Nilcreator/NinjaRobotV5/Wiki/NinjaRobotPi0_Wiki/raw/articles/pi0vl53l0x/README.md

# pi0vl53l0x

A robust Python driver for the VL53L0X Time-of-Flight distance sensor using pigpio.

## Features

- **Hardened initialization** — firmware boot polling (up to 1.0s) prevents "returns 0 after reboot" issue
- **Thread-safe ranging** — individual I2C operations and whole single-shot ranging transactions are serialized for background monitor + Blockly use
- **Automatic retry** — exponential backoff (10→20→50ms) with bus recovery on persistent failure
- **Defined exception contract** — `I2CError`, `TimeoutError`, `RuntimeError` for clear error handling
- **Async ready** — `get_range_async()` for asyncio integration
- **Config management** — JSON-based offset storage with export/import
- **Interactive CLI** — `sensor-tool` TUI with 8 menu options for guided sensor operations
- **Individual commands** — `get`, `test`, `status`, `calibrate`, `performance`, `config` for scripting
- **100% backward compatible** — drop-in replacement for ninja_core integration

## Directory Structure

```
pi0vl53l0x/
├── pyproject.toml              # Package metadata, dependencies, CLI entry point
├── README.md                   # This document
├── LICENSE
├── tests/                      # Unit tests (61 tests total)
│   ├── test_i2c.py             # I2C bus wrapper tests (22 tests)
│   ├── test_sensor.py          # VL53L0X driver tests (23 tests)
│   └── test_config.py          # Config manager tests (16 tests)
└── src/pi0vl53l0x/
    ├── __init__.py              # Package exports (VL53L0X, ConfigManager, I2CError)
    ├── __main__.py              # Entry point for `python -m pi0vl53l0x`
    ├── registers.py             # ~60 semantic register constants
    ├── driver.py                # Backward-compat shim (re-exports VL53L0X from core)
    ├── core/                    # Core sensor modules
    │   ├── __init__.py
    │   ├── i2c.py               # Thread-safe I2C bus wrapper with retry + recovery
    │   └── sensor.py            # VL53L0X driver (~1000 lines, implements Sensor ABC)
    ├── config/                  # Configuration management
    │   ├── __init__.py
    │   └── config_manager.py    # JSON load/save/export/import
    └── cli/                     # CLI commands
        ├── __init__.py
        └── sensor_tool.py       # Individual commands + interactive sensor-tool TUI
```

## Requirements

- Python ≥ 3.9
- `click` — CLI framework
- `blessed` — Terminal UI for interactive tool
- `ninja_utils` — logging and Sensor ABC
- `pigpio` — Raspberry Pi I2C (required on RPi)

## Installation (Standalone on Raspberry Pi)

### Step 1: Install `uv` (Python package manager)

```bash
curl -LsSf https://astral.sh/uv/install.sh | sh
source ~/.bashrc    # or restart your terminal
```

> **Note:** `uv` is a fast Python package manager that replaces `pip` and `venv`. It automatically creates a `.venv` and manages all dependencies.

### Step 2: Clone and install pi0vl53l0x

```bash
# Clone the repository (or copy the pi0vl53l0x folder to your Pi)
cd pi0vl53l0x

# Install all dependencies including pigpio for Raspberry Pi
uv sync --extra pi
```

### Step 3: Start pigpiod

```bash
sudo pigpiod
```

> **Tip:** To start pigpiod automatically on boot:
> ```bash
> sudo systemctl enable pigpiod
> ```

### Step 4: Verify installation

```bash
uv run pi0vl53l0x --help
uv run pi0vl53l0x test
```

## CLI — Interactive Sensor Tool

Launch the interactive TUI with 8 menu options for guided sensor operations:

```bash
# Launch the interactive TUI
uv run pi0vl53l0x sensor-tool

# With custom config file
uv run pi0vl53l0x sensor-tool --config my_sensor.json
```

The `sensor-tool` provides a menu-driven interface:

| # | Function | Description |
|---|---|---|
| 1 | Single Read | Take one distance measurement (repeat with Enter) |
| 2 | Continuous Read | Stream readings at configurable interval |
| 3 | Performance | Measure readings/second with statistics |
| 4 | Calibrate | Guided offset calibration at known distance |
| 5 | Health Check | Verify sensor connection and test reading |
| 6 | Status | Full diagnostics (health, offset, config, reading) |
| 7 | Config | Show/export/import sensor settings |
| 8 | Reinitialize | Reset sensor for recovery from stuck state |

## CLI — Individual Commands

Individual commands are ideal for scripting, automation, and quick one-off operations.

### Read Distance

```bash
# Single reading
uv run pi0vl53l0x get

# 10 readings at 0.5s intervals
uv run pi0vl53l0x get --count 10 --interval 0.5
```

### Quick Test

```bash
# Initialize sensor and take 5 test readings
uv run pi0vl53l0x test
```

### Health Status

```bash
# Full sensor health report (connection, offset, reading, config)
uv run pi0vl53l0x status
```

### Performance Benchmark

```bash
# Measure readings per second (100 samples)
uv run pi0vl53l0x performance --count 100
```

### Calibration

```bash
# Place a target at exactly 100mm from sensor, then run:
uv run pi0vl53l0x calibrate --distance 100 --count 10
```

### Configuration Management

```bash
# View current settings
uv run pi0vl53l0x config show

# Backup configuration
uv run pi0vl53l0x config export backup.json

# Restore configuration
uv run pi0vl53l0x config import backup.json
```

### Global Options

```bash
# Enable debug logging
uv run pi0vl53l0x --debug get --count 5

# Use custom config file
uv run pi0vl53l0x --config-file custom.json get
```

## Quick Start

### Python API

```python
import pigpio
from pi0vl53l0x import VL53L0X

pi = pigpio.pi()
sensor = VL53L0X(pi)  # Auto-initializes with firmware boot polling

# Single measurement
distance = sensor.get_range()
print(f"Distance: {distance} mm")

# Structured data with validity check
data = sensor.get_data()
if data["is_valid"]:
    print(f"Distance: {data['distance_mm']} mm (raw: {data['raw_value']} mm)")

# Calibration at known distance
offset = sensor.calibrate(target_distance_mm=100, num_samples=10)
sensor.set_offset(offset)

# Health check and recovery
if not sensor.health_check():
    sensor.reinitialize()

sensor.close()
pi.stop()
```

### Context Manager

```python
with VL53L0X(pi) as sensor:
    distance = sensor.get_range()
```

### Async Support

```python
distance = await sensor.get_range_async()
```

### Using with ninja_core (HAL Integration)

The library is loaded automatically by `ninja_core/hal.py` via the driver registry:

```python
# ninja_core imports it as:
from pi0vl53l0x.driver import VL53L0X
sensor = VL53L0X(pi)  # driver.py is a shim that re-exports from core.sensor
```

No changes to `ninja_core` are needed — both import paths work identically.

## API Reference

### VL53L0X (Constructor)

```python
VL53L0X(
    pi: pigpio.pi,
    i2c_bus: int = 1,
    i2c_address: int = 0x29,
    debug: bool = False,
    config_file_path: str | None = None,
    firmware_boot_timeout: float = 1.0,
)
```

| Parameter | Default | Description |
|---|---|---|
| `pi` | (required) | Shared pigpio connection |
| `i2c_bus` | `1` | I2C bus number |
| `i2c_address` | `0x29` | 7-bit I2C address |
| `debug` | `False` | Enable debug logging |
| `config_file_path` | `None` | Path to JSON config with `offset_mm` |
| `firmware_boot_timeout` | `1.0` | Firmware boot timeout in seconds |

> **Note:** The constructor auto-calls `initialize()`. If init fails, the I2C handle is cleaned up automatically.

### Measurement Methods

| Method | Returns | Description |
|---|---|---|
| `get_range()` | `int` | Single-shot distance in mm (with offset applied) |
| `get_data()` | `dict` | `{"distance_mm", "is_valid", "raw_value", "timestamp"}` |
| `get_ranges(num_samples)` | `list[int]` | Multiple consecutive measurements |
| `get_range_async()` | `int` | Async version (runs in thread pool executor) |

### Thread Safety

`I2CBus` serializes individual register reads and writes. `VL53L0X` also serializes the complete single-shot ranging transaction with an internal re-entrant measurement lock, so a background `DistanceMonitor` read and Blockly user code calling `robot.distance.read()` cannot interleave the register writes that start, poll, and clear a measurement.

`get_range()`, `get_data()`, `get_ranges()`, `get_range_async()`, `reinitialize()`, and `close()` all use this transaction-level protection where needed. This is important inside NinjaRobotV5 because the web IDE can execute Blockly loops while the server is also polling the same physical VL53L0X sensor.

### Calibration & Configuration

| Method | Returns | Description |
|---|---|---|
| `set_offset(offset_mm)` | `None` | Set distance offset in mm |
| `calibrate(target_distance_mm, num_samples)` | `int` | Measure and return calculated offset |

### Health & Recovery

| Method | Returns | Description |
|---|---|---|
| `health_check()` | `bool` | Verify sensor responds (reads Model ID) |
| `reinitialize()` | `None` | Full re-init for recovery; serialized with active ranging transactions |
| `close()` | `None` | Release I2C handle |

### I2CBus

Thread-safe I2C wrapper used internally by VL53L0X. It protects individual bus operations; the VL53L0X driver layers a measurement transaction lock above it for multi-register ranging flows.

```python
from pi0vl53l0x.core.i2c import I2CBus

bus = I2CBus(pi, bus=1, address=0x29, max_retries=3)
value = bus.read_byte(0xC0)  # Read Model ID register
bus.close()
```

| Method | Returns | Description |
|---|---|---|
| `read_byte(register)` | `int` | Read single byte |
| `write_byte(register, value)` | `None` | Write single byte |
| `read_word_big_endian(register)` | `int` | Read 16-bit word (byte-swap) |
| `write_word_big_endian(register, value)` | `None` | Write 16-bit word (byte-swap) |
| `read_block(register, count)` | `list[int]` | Read block of bytes |
| `write_block(register, data)` | `None` | Write block of bytes |
| `close()` | `None` | Close I2C handle |

### ConfigManager

```python
from pi0vl53l0x.config import ConfigManager

manager = ConfigManager()         # Uses default vl53l0x.json path
manager.load()                    # Load config from file
manager.set("offset_mm", 10)      # Set a value
manager.save()                    # Save to file
manager.export_config("backup.json")
manager.import_config("backup.json")
```

### Exception Contract

| Exception | When |
|---|---|
| `I2CError` | I2C bus failure after all retries exhausted |
| `TimeoutError` | Measurement/firmware boot did not complete within timeout |
| `RuntimeError` | Sensor not initialized |
| `ConnectionError` | Invalid Model ID (expected 0xEE) or connection failure |

## Testing

```bash
# Run all unit tests (61 tests)
uv run --extra dev pytest tests/ -v

# Lint check
uv run --extra dev ruff check src/ tests/
```

### Test Coverage

| Test File | Tests | Coverage |
|---|---|---|
| `test_i2c.py` | 22 | I2C ops, retry, recovery, thread safety |
| `test_sensor.py` | 23 | Init, ranging, offset, health, async, transaction lock, compat |
| `test_config.py` | 16 | Load/save, export/import, corrupt JSON |

### Manual Testing on Raspberry Pi

1. Start pigpiod: `sudo pigpiod`
2. Quick test: `uv run pi0vl53l0x test`
3. Health check: `uv run pi0vl53l0x status`
4. Read distances: `uv run pi0vl53l0x get --count 5`
5. Calibrate: `uv run pi0vl53l0x calibrate --distance 100 --count 10`
6. Interactive tool: `uv run pi0vl53l0x sensor-tool`

## Architecture

```
┌──────────────────────────────────────────────┐
│                  ninja_core                   │
│     hal.py → from pi0vl53l0x.driver import   │
│              VL53L0X (backward-compat shim)   │
└─────────────────────┬────────────────────────┘
                      │
┌─────────────────────▼────────────────────────┐
│              pi0vl53l0x package                │
│                                               │
│  ┌──────────┐  ┌──────────┐  ┌────────────┐  │
│  │ core/    │  │ config/  │  │ cli/       │  │
│  │  i2c.py  │  │ config_  │  │ sensor_    │  │
│  │  sensor  │  │ manager  │  │ tool.py    │  │
│  │  .py     │  │ .py      │  │            │  │
│  └────┬─────┘  └────┬─────┘  └────┬───────┘  │
│       │              │              │          │
│  registers.py   vl53l0x.json    click CLI     │
└──────────────────────────────────────────────┘
                      │
              pigpio I2C (bus 1)
                      │
              VL53L0X sensor (0x29)
```

## License

MIT License — © 2026 Chihkuang Chang
