Nilcreator/NinjaRobotV5/Wiki/NinjaRobotPi0_Wiki/wiki/concepts/perception-and-expression.md

---
type: Concept
title: Perception and Expression Systems
description: Time-of-Flight distance sensing, thread-safe measurement locks, animated
  LCD expressions, and emotion audio synthesis.
status: stable
generated:
  by: antigravity-agent/1
  at: '2026-08-22T14:22:00Z'
sources:
- id: src-20260822-readme-5
  resource: urn:llmwiki:source:src-20260822-readme-5
  title: pi0buzzer Readme
  content_hash: sha256:5b4e579a60463a96e8f0bec64a502a6bf78e068b0190f65e7793fa52666d0d45
- id: src-20260822-readme-6
  resource: urn:llmwiki:source:src-20260822-readme-6
  title: pi0disp Readme
  content_hash: sha256:2fe0452ebd0ffac5fad08cfc6c0452dd65acdc62f318b71d7050e123bb347682
- id: src-20260822-readme-8
  resource: urn:llmwiki:source:src-20260822-readme-8
  title: pi0vl53l0x Readme
  content_hash: sha256:6d02713847e83b720c6093afade910a3989dc1e8d8b48d889d61c1e381b7b680
- id: src-20260822-developmentguide
  resource: urn:llmwiki:source:src-20260822-developmentguide
  title: NinjaRobot V5 Development Guide
  content_hash: sha256:26272dce2ec7dcab9f3181e1ce0621448ef12547ff26f3b7a0ac4fc50cef9b4d
semantic_review:
  version: 1
  performed_by: agent:codex
  performed_at: '2026-09-01T07:28:37Z'
  target_hash: sha256:be0b0a4fec178421bbf8bbdeb4dfc8640ff7f33cb64d2e0ed8308e78c1492be7
  result: passed
  checks:
    source_support: passed
    contradictions: passed
    limitations: passed
    claim_strength: passed
    visual_evidence: not_applicable
  notes:
  - Driver concurrency and expression behavior are supported; bandwidth and responsiveness claims remain
    attributed to documentation rather than physical benchmarks.
---

# Perception and Expression Systems

NinjaRobot V5 combines environmental perception with multi-modal expressions (visual and acoustic) to deliver an engaging, interactive personality.[^src-20260822-developmentguide]

## Distance Perception (`pi0vl53l0x` & `DistanceMonitor`)

Distance sensing uses the VL53L0X Time-of-Flight sensor over I2C:[^src-20260822-readme-8]

* **Transaction-Level Locking**: Ranging requires multi-register read/write sequences. `pi0vl53l0x` wraps transactions in a `threading.RLock` so background polling in `DistanceMonitor` and user code in Blockly (`robot.distance.read()`) do not corrupt I2C bus state.[^src-20260822-readme-8] [^src-20260822-developmentguide]
* **Automatic Bus Recovery**: Transient I2C communication failures trigger exponential backoff (10→20→50ms) and automatic bus reset.[^src-20260822-readme-8]
* **Obstacle Safety**: In autonomous mode, proximity < 50mm immediately halts movements, displays a `scary` face, and triggers a warning sound.[^src-20260822-developmentguide]

## Visual Expressions (`pi0disp` & `AnimatedFaces`)

The visual expression engine renders expressive eyes and faces onto the 240×320 IPS display:[^src-20260822-readme-6] [^src-20260822-developmentguide]

* **Smart Delta Rendering**: `pi0disp` calculates bounding boxes of modified pixels via `PIL.ImageChops.difference()`, transmitting only changed areas over SPI; the source documentation reports approximately 90% bandwidth reduction for animations.[^src-20260822-readme-6]
* **Thread-Safe SPI Lock**: Protects display transfers against concurrent access by web server status threads and facial animation loops.[^src-20260822-readme-6]
* **Expression Library**: Pre-rendered and dynamic animations including `happy`, `sad`, `angry`, `confusing`, `cry`, `embarrassing`, `idle`, `laughing`, `scary`, `shy`, `sleepy`, `speaking`, and `surprising`.[^src-20260822-readme-6] [^src-20260822-developmentguide]

## Acoustic Emotion Synthesis (`pi0buzzer`)

Audio is generated using a passive buzzer driven by hardware PWM on GPIO 17:[^src-20260822-readme-5]

* **Non-Blocking Queue Worker**: Sound sequences are processed in a dedicated background worker thread, keeping queued playback work off the calling thread.[^src-20260822-readme-5]
* **Musical Notes**: 35 standard note frequencies across 5 octaves (C3–B7).[^src-20260822-readme-5]
* **14 Emotion Sound Effects**: Acoustic signatures mapped to matching facial expressions.[^src-20260822-readme-5]
* **Built-in Song Catalog**: Melodies including `happy_birthday`, `jingle_bells`, `twinkle_twinkle_little_star`, and `head_shoulders_knees_and_toes`.[^src-20260822-developmentguide]

[^src-20260822-readme-5]: pi0buzzer Readme.
[^src-20260822-readme-6]: pi0disp Readme.
[^src-20260822-readme-8]: pi0vl53l0x Readme.
[^src-20260822-developmentguide]: NinjaRobot V5 Development Guide.
