Nilcreator/NinjaRobotV5/Wiki/NinjaRobotPi0_Wiki/wiki/concepts/index.md

# Concepts

* [Action Library and AI Agent](action-library-and-ai-agent.md) - Google Gemini-powered agentic AI, saved Blockly action library, action chaining, and cooperative interruption.
* [Architecture and Hardware Abstraction Layer](architecture-and-hal.md) - Monorepo structure, dynamic driver loading, interface ABCs, and centralized configuration in NinjaRobot V5.
* [Dual Connectivity and Communication Protocols](dual-connectivity-and-protocols.md) - Dual Wi-Fi and Bluetooth Low Energy connectivity, GATT service specifications, and chunked transfer protocols.
* [Motion System and Easing Curves](motion-system-and-easing.md) - Velocity-based physics motion calculations, position-aware easing curves, and the movement command syntax.
* [Perception and Expression Systems](perception-and-expression.md) - Time-of-Flight distance sensing, thread-safe measurement locks, animated LCD expressions, and emotion audio synthesis.
* [Safe Code Execution and Blockly Runtime](safe-execution-and-blockly-runtime.md) - Sandboxed Python execution, AST compilation preflight, runtime ownership switching, and GPIO-first wrapper contracts.
