Nilcreator/NinjaRobotV5/Wiki/NinjaRobotPi0_Wiki/wiki/analyses/index.md

# Analyses

* [Development History and Evolution](development-history-and-evolution.md) - Chronological development history of NinjaRobot V5 across major phases, version milestones, and reliability audits.
* [Hardware Driver Rebuild and Vulnerability Analysis](driver-rebuild-and-vulnerability-analysis.md) - In-depth analysis of legacy driver limitations, blocking delays, concurrency race conditions, and V5 architectural solutions.
