Nilcreator/NinjaRobotV5/Wiki/NinjaRobotPi0_Wiki/wiki/references/index.md

# References

* [API and CLI Reference](api-and-cli-reference.md) - Unified reference of all Python driver classes, wrapper APIs, REST/WebSocket endpoints, and CLI tools.
* [Hardware Calibration and Testing Tools Reference](hardware-calibration-and-tools.md) - Comprehensive guide to interactive calibration TUIs, setup wizards, and diagnostic tools.
* [Installation and Hardware Wiring Reference](installation-and-wiring.md) - Step-by-step assembly, complete GPIO wiring tables, Raspberry Pi OS Bookworm setup, and pigpio compilation.
