Nilcreator/NinjaRobotV5/Wiki/NinjaRobotPi0_Wiki/wiki/log.md

# Wiki Update Log

## 2026-09-01

* **Update**: Applied plan `plan-20260901-review-safe-execution-and-blockly-runtime` — Record a source-backed semantic review for wiki/concepts/safe-execution-and-blockly-runtime.md; page content is unchanged.. Sources: `src-20260822-developmentguide`, `src-20260822-readme-3`, `src-20260822-developmentlog`.

* **Update**: Applied plan `plan-20260901-review-pi0vl53l0x` — Record a source-backed semantic review for wiki/entities/pi0vl53l0x.md; page content is unchanged.. Sources: `src-20260822-readme-8`, `src-20260822-developmentguide`, `src-20260822-developmentlog`.

* **Update**: Applied plan `plan-20260901-review-pi0servo` — Record a source-backed semantic review for wiki/entities/pi0servo.md; page content is unchanged.. Sources: `src-20260822-readme-7`, `src-20260822-developmentguide`, `src-20260822-projectupgradeplan`.

* **Update**: Applied plan `plan-20260901-review-pi0disp` — Record a source-backed semantic review for wiki/entities/pi0disp.md; page content is unchanged.. Sources: `src-20260822-readme-6`, `src-20260822-developmentguide`.

* **Update**: Applied plan `plan-20260901-review-pi0buzzer` — Record a source-backed semantic review for wiki/entities/pi0buzzer.md; page content is unchanged.. Sources: `src-20260822-readme-5`, `src-20260822-developmentguide`.

* **Update**: Applied plan `plan-20260901-review-perception-and-expression` — Record a source-backed semantic review for wiki/concepts/perception-and-expression.md; page content is unchanged.. Sources: `src-20260822-readme-5`, `src-20260822-readme-6`, `src-20260822-readme-8`, `src-20260822-developmentguide`.

* **Update**: Applied plan `plan-20260901-review-overview` — Record a source-backed semantic review for wiki/overview.md; page content is unchanged.. Sources: `src-20260822-readme`, `src-20260822-developmentguide`.

* **Update**: Applied plan `plan-20260901-review-ninjarobot-v5` — Record a source-backed semantic review for wiki/entities/ninjarobot-v5.md; page content is unchanged.. Sources: `src-20260822-readme`, `src-20260822-developmentguide`, `src-20260822-installationguide`.

* **Update**: Applied plan `plan-20260901-review-ninja-webapp` — Record a source-backed semantic review for wiki/entities/ninja-webapp.md; page content is unchanged.. Sources: `src-20260822-developmentguide`, `src-20260822-readme`.

* **Update**: Applied plan `plan-20260901-review-ninja-utils` — Record a source-backed semantic review for wiki/entities/ninja-utils.md; page content is unchanged.. Sources: `src-20260822-readme-4`, `src-20260822-developmentguide`.

* **Update**: Applied plan `plan-20260901-review-ninja-core` — Record a source-backed semantic review for wiki/entities/ninja-core.md; page content is unchanged.. Sources: `src-20260822-readme-3`, `src-20260822-developmentguide`, `src-20260822-developmentlog`.

* **Update**: Applied plan `plan-20260901-review-ninja-ble` — Record a source-backed semantic review for wiki/entities/ninja-ble.md; page content is unchanged.. Sources: `src-20260822-readme-2`, `src-20260822-developmentguide`, `src-20260822-developmentlog`.

* **Update**: Applied plan `plan-20260901-review-motion-system-and-easing` — Record a source-backed semantic review for wiki/concepts/motion-system-and-easing.md; page content is unchanged.. Sources: `src-20260822-readme-7`, `src-20260822-readme-3`, `src-20260822-developmentguide`.

* **Update**: Applied plan `plan-20260901-review-installation-and-wiring` — Record a source-backed semantic review for wiki/references/installation-and-wiring.md; page content is unchanged.. Sources: `src-20260822-installationguide`, `src-20260822-developmentguide`.

* **Update**: Applied plan `plan-20260901-review-hardware-calibration-and-tools` — Record a source-backed semantic review for wiki/references/hardware-calibration-and-tools.md; page content is unchanged.. Sources: `src-20260822-installationguide`, `src-20260822-developmentguide`, `src-20260822-readme-7`, `src-20260822-readme-6`, `src-20260822-readme-5`, `src-20260822-readme-8`.

* **Update**: Applied plan `plan-20260901-review-dual-connectivity-and-protocols` — Record a source-backed semantic review for wiki/concepts/dual-connectivity-and-protocols.md; page content is unchanged.. Sources: `src-20260822-readme-2`, `src-20260822-developmentguide`, `src-20260822-readme`, `src-20260822-developmentlog`.

* **Update**: Applied plan `plan-20260901-review-driver-rebuild-and-vulnerability-analysis` — Record a source-backed semantic review for wiki/analyses/driver-rebuild-and-vulnerability-analysis.md; page content is unchanged.. Sources: `src-20260822-projectupgradeplan`, `src-20260822-developmentguide`.

* **Update**: Applied plan `plan-20260901-review-development-history-and-evolution` — Record a source-backed semantic review for wiki/analyses/development-history-and-evolution.md; page content is unchanged.. Sources: `src-20260822-developmentlog`, `src-20260822-developmentguide`.

* **Update**: Applied plan `plan-20260901-review-architecture-and-hal` — Record a source-backed semantic review for wiki/concepts/architecture-and-hal.md; page content is unchanged.. Sources: `src-20260822-developmentguide`, `src-20260822-readme-3`, `src-20260822-readme-4`.

* **Update**: Applied plan `plan-20260901-review-api-and-cli-reference` — Record a source-backed semantic review for wiki/references/api-and-cli-reference.md; page content is unchanged.. Sources: `src-20260822-developmentguide`, `src-20260822-readme-2`, `src-20260822-readme-3`, `src-20260822-readme-5`, `src-20260822-readme-6`, `src-20260822-readme-7`, `src-20260822-readme-8`.

* **Update**: Applied plan `plan-20260901-review-action-library-and-ai-agent` — Record a source-backed semantic review for wiki/concepts/action-library-and-ai-agent.md; page content is unchanged.. Sources: `src-20260822-developmentguide`, `src-20260822-readme-3`, `src-20260822-developmentlog`.

* **Update**: Applied plan `plan-20260901-semantic-content-corrections` — Correct source conflicts and over-strong wording found during the full semantic review, while preserving current robot behavior.. Sources: `src-20260822-developmentguide`, `src-20260822-developmentlog`, `src-20260822-installationguide`, `src-20260822-projectupgradeplan`, `src-20260822-readme`, `src-20260822-readme-2`, `src-20260822-readme-3`, `src-20260822-readme-4`, `src-20260822-readme-5`, `src-20260822-readme-6`, `src-20260822-readme-7`, `src-20260822-readme-8`.

* **Update**: Applied plan `plan-20260901-gemini-runtime-ingestion` — Refresh all sourced wiki pages to current registered document hashes and ingest Gemini model-selection and Gemini 3 runtime compatibility behavior.. Sources: `src-20260822-developmentguide`, `src-20260822-developmentlog`, `src-20260822-installationguide`, `src-20260822-projectupgradeplan`, `src-20260822-readme`, `src-20260822-readme-2`, `src-20260822-readme-3`, `src-20260822-readme-4`, `src-20260822-readme-5`, `src-20260822-readme-6`, `src-20260822-readme-7`, `src-20260822-readme-8`.

## 2026-08-23

* **Update**: Applied plan `plan-20260823-semantic-reviews` — Add source-grounded semantic reviews for all 21 unreviewed knowledge pages. Sources: `src-20260822-developmentguide`, `src-20260822-developmentlog`, `src-20260822-installationguide`, `src-20260822-projectupgradeplan`, `src-20260822-readme`, `src-20260822-readme-2`, `src-20260822-readme-3`, `src-20260822-readme-4`, `src-20260822-readme-5`, `src-20260822-readme-6`, `src-20260822-readme-7`, `src-20260822-readme-8`.

## 2026-08-22

* **Update**: Applied plan `ingest-all-raw-sources` — Ingest all 12 registered raw sources into comprehensive OKF v0.2 knowledge bundle (21 pages). Sources: `src-20260822-readme`, `src-20260822-developmentguide`, `src-20260822-installationguide`, `src-20260822-projectupgradeplan`, `src-20260822-readme-2`, `src-20260822-readme-3`, `src-20260822-readme-4`, `src-20260822-readme-5`, `src-20260822-readme-6`, `src-20260822-readme-7`, `src-20260822-readme-8`, `src-20260822-developmentlog`.

* **Initialization**: Created the empty Local LLM Wiki template.
