Nilcreator/NinjaRobotV5/Wiki/NinjaRobotPi0_Wiki/wiki/index.md

---
okf_version: "0.2"
---

# Local LLM Wiki

* [NinjaRobot V5 Platform Overview](overview.md) - Comprehensive overview of the NinjaRobot V5 AI-powered educational and research robotics platform.
* [Analyses](analyses/) - Browse analyses in this bundle.
* [Concepts](concepts/) - Browse concepts in this bundle.
* [Entities](entities/) - Browse entities in this bundle.
* [References](references/) - Browse references in this bundle.
