Nilcreator/NinjaRobotV5/3Dmodels/NinjaV5/NinjaV5_Bottom.stl

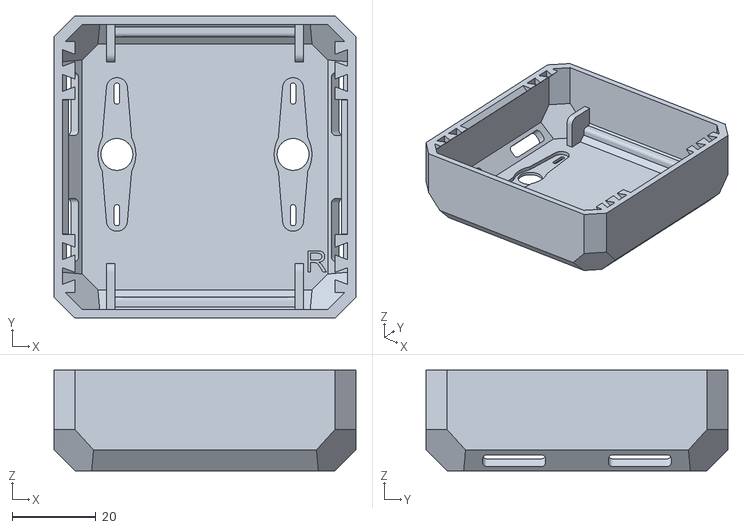
[picture p3: CAD file, 2026-04-27]
3Dmodels/NinjaV5/NinjaV5_Bottom.stl
72.0 x 72.0 x 24.0
