Nilcreator/NinjaRobotV5/3Dmodels/Satsuke/SastukeV5_Arm_Left.stl

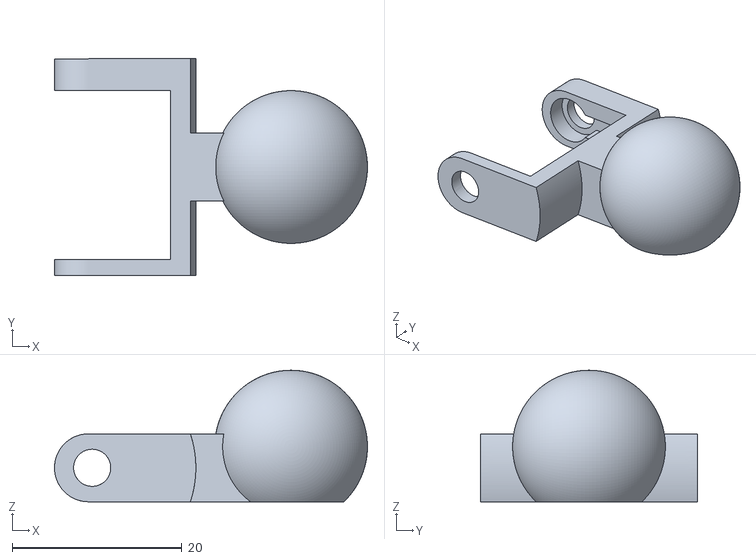
[picture p4: CAD file, 2026-04-27]
3Dmodels/Satsuke/SastukeV5_Arm_Left.stl
36.9 x 25.5 x 15.5
