Nilcreator/NinjaRobotV5/3Dmodels/Spider/SpiderV5_BodyServo_Pin.stl

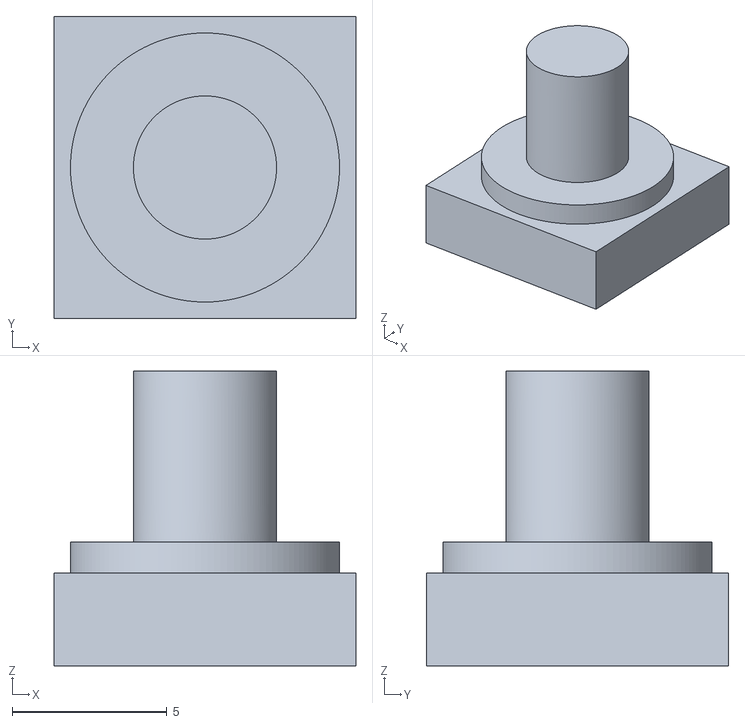
[picture p5: CAD file, 2026-04-27]
3Dmodels/Spider/SpiderV5_BodyServo_Pin.stl
9.75 x 9.76 x 9.51
