Nilcreator/NinjaRobotV5/3Dmodels/NinjaV5/NinjaV5_Top.stl

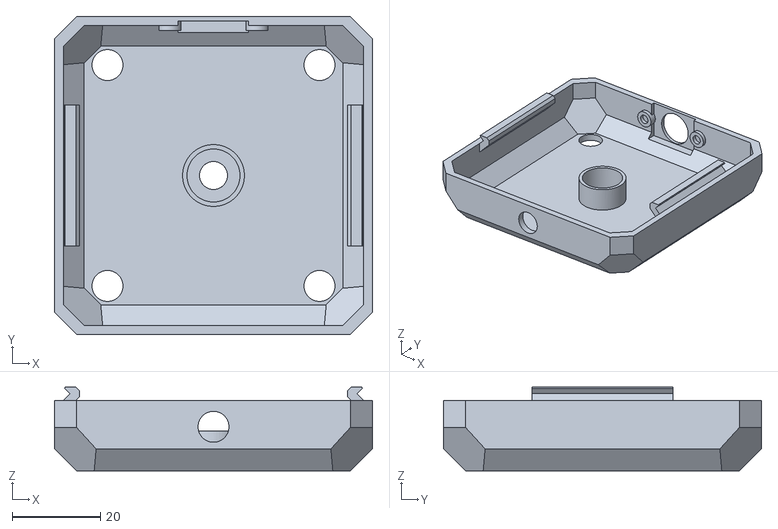
[picture p6: CAD file, 2026-04-27]
3Dmodels/NinjaV5/NinjaV5_Top.stl
72.0 x 72.0 x 19.0
