Nilcreator/NinjaRobotV5/3Dmodels/Satsuke/SastukeV5_Feet_Right.stl

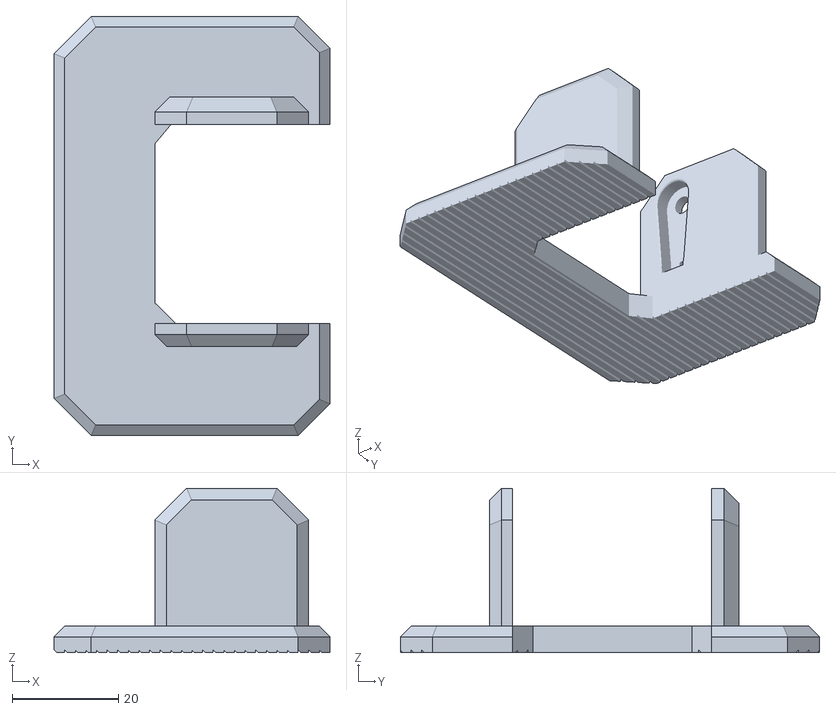
[picture p7: CAD file, 2026-04-27]
3Dmodels/Satsuke/SastukeV5_Feet_Right.stl
52.0 x 79.0 x 31.0
