Nilcreator/NinjaRobotV5/3Dmodels/Spider/SpiderV5_Legs_01.stl

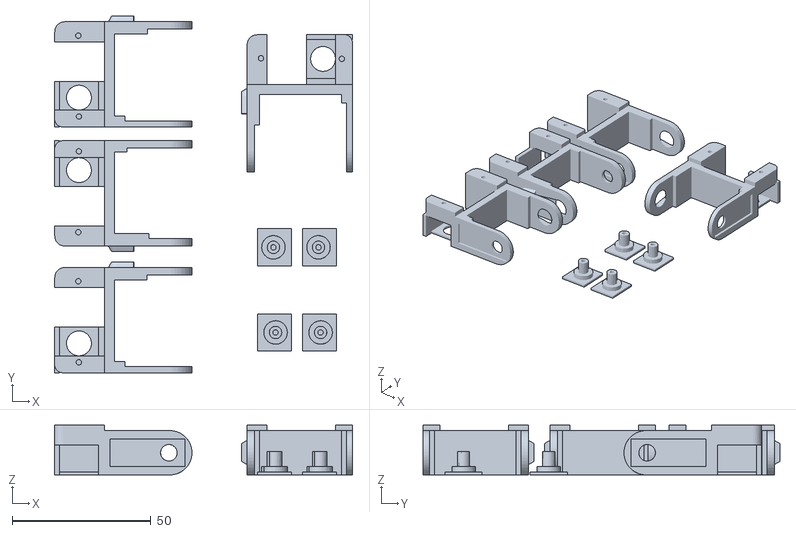
[picture p8: CAD file, 2026-04-27]
3Dmodels/Spider/SpiderV5_Legs_01.stl
107.5 x 128.6 x 18.0
