Nilcreator/NinjaRobotV5/3Dmodels/NinjaV5/NinjaV5_LED.stl

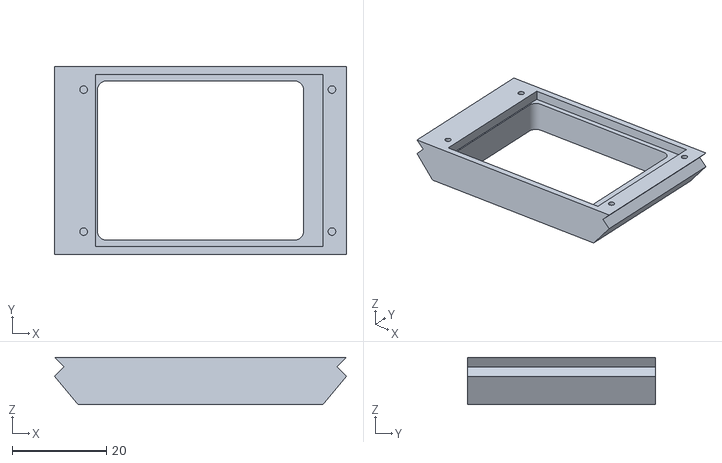
[picture p9: CAD file, 2026-04-27]
3Dmodels/NinjaV5/NinjaV5_LED.stl
62.0 x 40.0 x 10.0
