Nilcreator/NinjaRobotV5/3Dmodels/Satsuke/SastukeV5_SeovoHolder_Left.stl

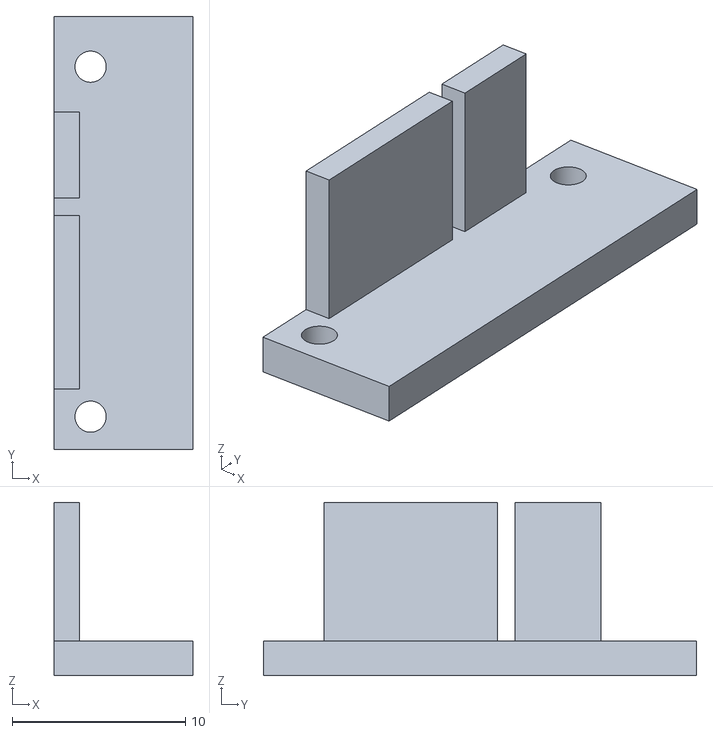
[picture p10: CAD file, 2026-04-27]
3Dmodels/Satsuke/SastukeV5_SeovoHolder_Left.stl
8.00 x 25.0 x 10.0
