Nilcreator/NinjaRobotV5/3Dmodels/Spider/SpiderV5_Feet_02.stl

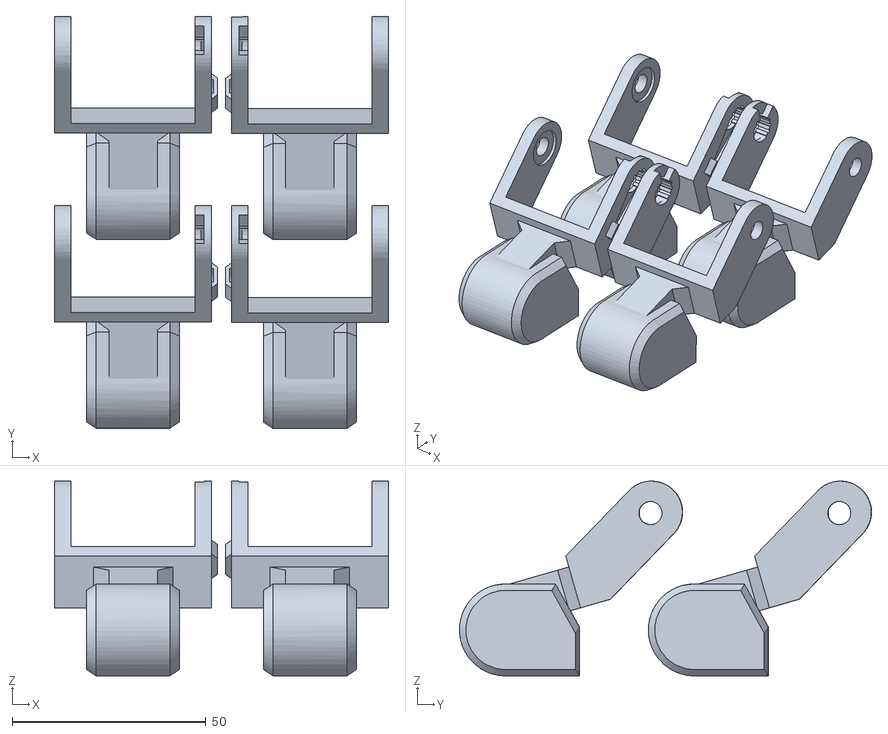
[picture p11: CAD file, 2026-04-27]
3Dmodels/Spider/SpiderV5_Feet_02.stl
86.1 x 106.3 x 50.2
