Nilcreator/NinjaRobotV5/3Dmodels/NinjaV5/NinjaV5_Middle.stl

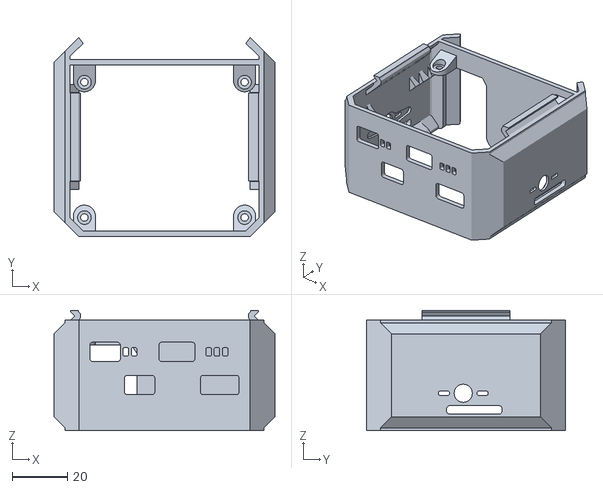
[picture p12: CAD file, 2026-04-27]
3Dmodels/NinjaV5/NinjaV5_Middle.stl
80.0 x 72.0 x 43.5
