Nilcreator/NinjaRobotV5/3Dmodels/Satsuke/SastukeV5_Shoulder_Left.stl

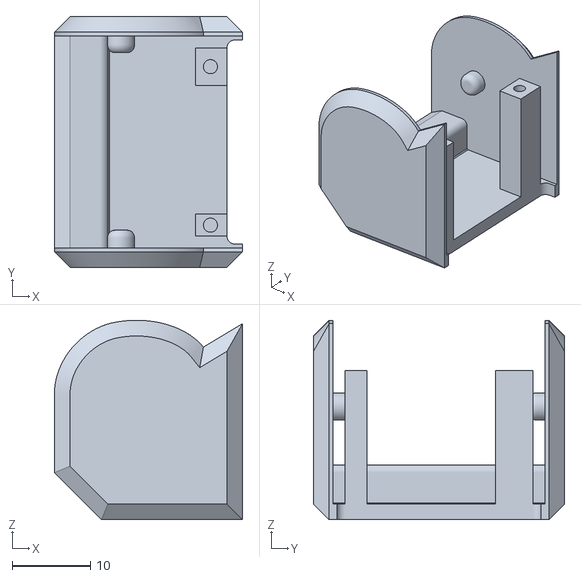
[picture p13: CAD file, 2026-04-27]
3Dmodels/Satsuke/SastukeV5_Shoulder_Left.stl
24.0 x 32.0 x 25.4
