Nilcreator/NinjaRobotV5/3Dmodels/Spider/SpiderV5_LegHolder.stl

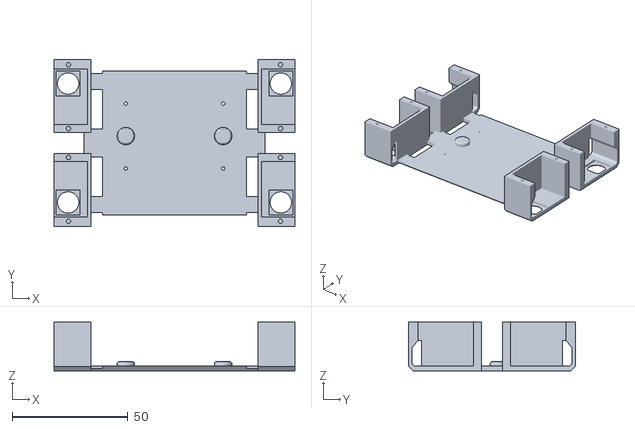
[picture p14: CAD file, 2026-04-27]
3Dmodels/Spider/SpiderV5_LegHolder.stl
104.0 x 72.0 x 21.0
