Nilcreator/NinjaRobotV5/3Dmodels/Satsuke/SastukeV5_Legs.stl

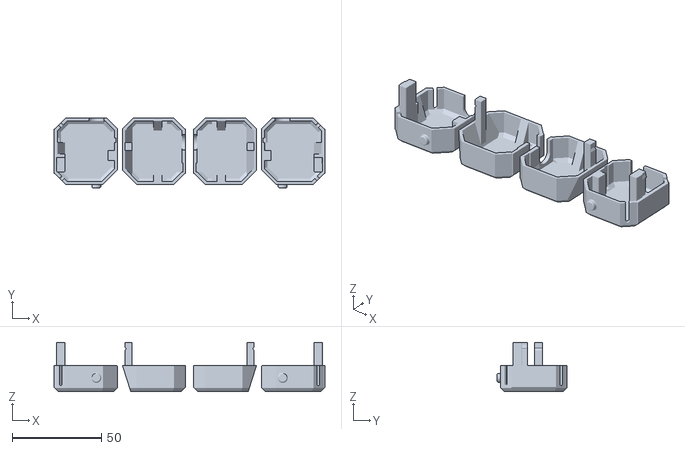
[picture p15: CAD file, 2026-04-27]
3Dmodels/Satsuke/SastukeV5_Legs.stl
151.8 x 39.0 x 27.5
