Nilcreator/NinjaRobotV5/Wiki/NinjaRobotPi0_Wiki/wiki/analyses/driver-rebuild-and-vulnerability-analysis.md

---
type: Analysis
title: Hardware Driver Rebuild and Vulnerability Analysis
description: In-depth analysis of legacy driver limitations, blocking delays, concurrency
  race conditions, and V5 architectural solutions.
status: stable
generated:
  by: antigravity-agent/1
  at: '2026-08-22T14:22:00Z'
sources:
- id: src-20260822-projectupgradeplan
  resource: urn:llmwiki:source:src-20260822-projectupgradeplan
  title: NinjaRobot V5 Project Upgrade Plan
  content_hash: sha256:e4c2e08c7e62522fe2d289456b9f7d27db2058691e93e0bc8bb72d72d5498c59
- id: src-20260822-developmentguide
  resource: urn:llmwiki:source:src-20260822-developmentguide
  title: NinjaRobot V5 Development Guide
  content_hash: sha256:26272dce2ec7dcab9f3181e1ce0621448ef12547ff26f3b7a0ac4fc50cef9b4d
semantic_review:
  version: 1
  performed_by: agent:codex
  performed_at: '2026-09-01T07:28:37Z'
  target_hash: sha256:f56f702ba6d51b3328118ce99f4f93c572af3b607b4726c9aa6cb12431d8926a
  result: passed
  checks:
    source_support: passed
    contradictions: passed
    limitations: passed
    claim_strength: passed
    visual_evidence: not_applicable
  notes:
  - Legacy risks and mitigations are source-supported; performance figures are explicitly presented as
    documented goals or approximations, not independent benchmarks.
---

# Hardware Driver Rebuild and Vulnerability Analysis

During the evolution from legacy NinjaRobot versions to NinjaRobot V5, project planning and development records identified significant architectural vulnerabilities in the original hardware drivers.[^src-20260822-projectupgradeplan] [^src-20260822-developmentguide] This document summarizes those documented vulnerabilities and the design patterns implemented to mitigate them.[^src-20260822-projectupgradeplan]

## Legacy Driver Vulnerability Matrix

| Component | Vulnerability | Severity | Impact in Legacy Architecture | V5 Architectural Solution |
|---|---|---|---|---|
| **`pi0servo`** | Blocking `time.sleep()` | 🔴 Critical | Synchronous servo motion blocked the FastAPI event loop, causing dropped WebSockets and unresponsive BLE.[^src-20260822-projectupgradeplan] | Velocity-based 100Hz generator with non-blocking async execution and `abort()` signal.[^src-20260822-developmentguide] |
| **`pi0servo`** | Unbounded Motion Timing | 🟡 Medium | Inconsistent multi-servo step arrival times.[^src-20260822-projectupgradeplan] | Position-aware cubic easing (`ease_in_cubic` → `linear` → `ease_out_cubic`).[^src-20260822-developmentguide] |
| **`pi0vl53l0x`**| Non-Atomic I2C Transactions | 🔴 Critical | Concurrency race condition between background `DistanceMonitor` and Blockly user scripts corrupted I2C state.[^src-20260822-developmentguide] | Multi-register ranging transactions wrapped in re-entrant `threading.RLock` + automatic bus recovery.[^src-20260822-developmentguide] |
| **`pi0vl53l0x`**| Unhandled Reboot State | 🟡 Medium | Sensor returned 0mm distance following hardware reboot.[^src-20260822-developmentguide] | Hardened firmware boot polling loop (up to 1.0s timeout).[^src-20260822-developmentguide] |
| **`pi0disp`** | Full-Frame SPI Transfers | 🟡 Medium | Transferring full 240×320×2 bytes (153.6 KB) per frame saturated SPI bandwidth and caused animation stutter.[^src-20260822-developmentguide] | Smart delta rendering transmitting only modified bounding boxes (documented as approximately 90% bandwidth reduction for animations).[^src-20260822-developmentguide] |
| **`pi0disp`** | Thread Contention on SPI | 🟡 Medium | Concurrent drawing from web server and facial expression threads garbled display output.[^src-20260822-developmentguide] | Thread-safe SPI locking (`threading.Lock`).[^src-20260822-developmentguide] |
| **`pi0buzzer`** | Blocking Tone Playback | 🔴 Critical | Tone playback delayed execution of subsequent robot actions.[^src-20260822-developmentguide] | Dedicated background worker thread with thread-safe sound queue.[^src-20260822-developmentguide] |

## Architectural Takeaways

1. **Avoid Blocking Driver Loops**: Low-power single-board computers such as the Raspberry Pi Zero 2W should keep blocking delays out of asynchronous driver paths.[^src-20260822-projectupgradeplan] [^src-20260822-developmentguide]
2. **Transaction-Level Concurrency**: Protecting single-byte I2C/SPI writes is insufficient; entire multi-register conversational transactions must be serialized.[^src-20260822-developmentguide]
3. **Bandwidth Optimization**: The documented display design uses dirty-rectangle tracking to reduce SPI traffic and work toward its 30+ FPS animation goal.[^src-20260822-developmentguide]

[^src-20260822-projectupgradeplan]: NinjaRobot V5 Project Upgrade Plan.
[^src-20260822-developmentguide]: NinjaRobot V5 Development Guide.
