Nilcreator/NinjaRobotV5/pi0servo/src/pi0servo/core/multi_servos.py

"""Multi-servo group controller with abort support.

This module provides the ServoGroup class which handles:
- Coordinated multi-servo movement
- Abort mechanism via threading.Event
- Velocity-based duration calculation
- Easing curves for smooth motion
"""

import asyncio
import logging
import threading
from typing import Callable

# Optional ninja_utils integration (fallback to standard logging)
try:
    from ninja_utils import get_module_logger
    logger = get_module_logger(__name__)
except ImportError:
    logger = logging.getLogger(__name__)

from ..motion import (
    EASING_FUNCTIONS,
    calculate_duration,
    ease_in_out_cubic,
)
from ..parser import ParsedCommand, ServoTarget, parse_command, resolve_special_angle
from .servo import Servo, ServoCalibration

# Step interval for motion interpolation (10ms = 100Hz for smoother motion)
STEP_INTERVAL = 0.01


class ServoGroup:
    """Multi-servo controller with synchronized movement and abort support.

    Implements the Actuator interface from ninja_utils.

    Key features:
    - Coordinated movement of multiple servos with easing
    - Abortable motion via threading.Event (sync) or asyncio.Event (async)
    - Velocity-based duration calculation (respects per-servo speed limits)
    - Command string parsing (movement-tool format)
    """

    def __init__(
        self,
        pi,
        pins: list[int],
        calibrations: dict[int, ServoCalibration] | None = None,
    ):
        """Initialize a ServoGroup.

        Args:
            pi: pigpio.pi() instance
            pins: List of GPIO pin numbers
            calibrations: Optional dict mapping pin to ServoCalibration
        """
        self._pi = pi
        self._pins = list(pins)
        self._servos: dict[int, Servo] = {}
        self._abort_event = threading.Event()
        self._async_abort_event = asyncio.Event()

        # Create Servo instances
        calibrations = calibrations or {}
        for pin in self._pins:
            cal = calibrations.get(pin)
            self._servos[pin] = Servo(pi, pin, cal)

    @property
    def pins(self) -> list[int]:
        """List of GPIO pins."""
        return list(self._pins)

    @property
    def servos(self) -> dict[int, Servo]:
        """Dictionary of pin -> Servo."""
        return self._servos

    def get_servo(self, pin: int) -> Servo | None:
        """Get a Servo by pin number.

        Args:
            pin: GPIO pin number

        Returns:
            Servo instance or None if not found
        """
        return self._servos.get(pin)

    def update_calibration(self, pin: int, calibration: ServoCalibration):
        """Update calibration for a specific servo.

        Args:
            pin: GPIO pin number
            calibration: New calibration data
        """
        if pin in self._servos:
            self._servos[pin].calibration = calibration

    def abort(self):
        """Signal abort for any running movement.

        Thread-safe. Can be called from any thread.
        """
        logger.info("Abort signal received")
        self._abort_event.set()
        self._async_abort_event.set()

    def _reset_abort(self):
        """Reset abort events for new movement."""
        self._abort_event.clear()
        self._async_abort_event.clear()

    def _is_aborted(self) -> bool:
        """Check if abort was signaled."""
        return self._abort_event.is_set()

    def _abortable_sleep(self, duration: float) -> bool:
        """Sleep that can be interrupted by abort.

        Args:
            duration: Sleep duration in seconds

        Returns:
            True if slept fully, False if aborted
        """
        if self._abort_event.wait(timeout=duration):
            logger.info("Sleep aborted after partial wait")
            return False
        return True

    async def _abortable_sleep_async(self, duration: float) -> bool:
        """Async sleep that can be interrupted by abort.

        Args:
            duration: Sleep duration in seconds

        Returns:
            True if slept fully, False if aborted
        """
        try:
            await asyncio.wait_for(
                self._async_abort_event.wait(),
                timeout=duration,
            )
            # If we get here, abort was signaled
            logger.info("Async sleep aborted")
            return False
        except asyncio.TimeoutError:
            # Normal case - sleep completed without abort
            return True

    def move_all_sync(
        self,
        targets: list[float | None],
        speed_mode: str | list[str] = "M",
        easing: str | Callable[[float], float] = "ease_in_out_cubic",
        force: bool = False,
    ) -> bool:
        """Move all servos to target angles with per-servo speed control.

        Each servo moves at its own calibrated speed. Faster servos reach
        their target before slower ones.

        Args:
            targets: List of target angles (same order as pins). None = skip.
            speed_mode: Either a single mode ("F"/"M"/"S") for all servos,
                       or a list of modes (one per pin) for per-servo control.
            easing: Easing function name or callable
            force: If True, send PWM even for very small movements (prevents limpness)

        Returns:
            True if completed successfully, False if aborted
        """
        import time

        self._reset_abort()

        # Resolve easing function
        if isinstance(easing, str):
            easing_fn = EASING_FUNCTIONS.get(easing, ease_in_out_cubic)
        else:
            easing_fn = easing

        # Normalize speed_mode to list
        if isinstance(speed_mode, str):
            speed_modes = [speed_mode] * len(self._pins)
        else:
            speed_modes = speed_mode

        # Build movement plan with per-servo duration
        # (servo, start, end, duration)
        movements: list[tuple[Servo, float, float, float]] = []
        max_duration = 0.0

        for i, pin in enumerate(self._pins):
            if i >= len(targets) or targets[i] is None:
                continue

            servo = self._servos[pin]
            target = targets[i]

            # Get current angle (default to center if unknown)
            current = servo.last_angle
            if current is None:
                current = servo.get_angle()
            if current is None:
                current = servo.calibration.angle_center

            distance = abs(target - current)
            if distance < 0.1 and not force:
                # Skip negligible movement (but log it for debugging)
                logger.debug(
                    f"Skip GPIO{pin}: target={target:.1f}° current={current:.1f}° "
                    f"distance={distance:.3f}° (< 0.1° threshold)"
                )
                continue

            # Use per-servo speed mode
            servo_speed_mode = speed_modes[i] if i < len(speed_modes) else "M"
            duration = calculate_duration(distance, servo.speed_limit, servo_speed_mode)
            max_duration = max(max_duration, duration)
            movements.append((servo, current, target, duration))

        if not movements:
            logger.debug("No movement required")
            return True

        logger.info(
            f"Moving {len(movements)} servos, max_duration={max_duration:.2f}s"
        )

        # Execute time-based movement (each servo progresses independently)
        start_time = time.monotonic()

        while True:
            if self._is_aborted():
                logger.info("Movement aborted")
                return False

            elapsed = time.monotonic() - start_time
            if elapsed >= max_duration:
                break

            for servo, start, end, duration in movements:
                if duration <= 0:
                    servo.set_angle(end)
                    continue

                # Per-servo progress based on its own duration
                t = min(1.0, elapsed / duration)
                eased_t = easing_fn(t)
                angle = start + (end - start) * eased_t
                servo.set_angle(angle)

            if not self._abortable_sleep(STEP_INTERVAL):
                return False

        # Ensure all servos reach their final target
        for servo, start, end, duration in movements:
            servo.set_angle(end)

        logger.debug("Movement completed successfully")
        return True

    async def move_all_async(
        self,
        targets: list[float | None],
        speed_mode: str | list[str] = "M",
        easing: str | Callable[[float], float] = "ease_in_out_cubic",
    ) -> bool:
        """Async version of move_all_sync with per-servo speed control.

        Non-blocking movement using asyncio.sleep instead of time.sleep.

        Args:
            targets: List of target angles (same order as pins). None = skip.
            speed_mode: Either a single mode ("F"/"M"/"S") for all servos,
                       or a list of modes (one per pin) for per-servo control.
            easing: Easing function name or callable

        Returns:
            True if completed successfully, False if aborted
        """
        import time

        self._reset_abort()

        # Resolve easing function
        if isinstance(easing, str):
            easing_fn = EASING_FUNCTIONS.get(easing, ease_in_out_cubic)
        else:
            easing_fn = easing

        # Normalize speed_mode to list
        if isinstance(speed_mode, str):
            speed_modes = [speed_mode] * len(self._pins)
        else:
            speed_modes = speed_mode

        # Build movement plan with per-servo duration
        movements: list[tuple[Servo, float, float, float]] = []
        max_duration = 0.0

        for i, pin in enumerate(self._pins):
            if i >= len(targets) or targets[i] is None:
                continue

            servo = self._servos[pin]
            target = targets[i]

            current = servo.last_angle
            if current is None:
                current = servo.get_angle()
            if current is None:
                current = servo.calibration.angle_center

            distance = abs(target - current)
            if distance < 0.1:
                continue

            # Use per-servo speed mode
            servo_speed_mode = speed_modes[i] if i < len(speed_modes) else "M"
            duration = calculate_duration(distance, servo.speed_limit, servo_speed_mode)
            max_duration = max(max_duration, duration)
            movements.append((servo, current, target, duration))

        if not movements:
            return True

        # Execute time-based movement
        start_time = time.monotonic()

        while True:
            if self._async_abort_event.is_set():
                return False

            elapsed = time.monotonic() - start_time
            if elapsed >= max_duration:
                break

            for servo, start, end, duration in movements:
                if duration <= 0:
                    servo.set_angle(end)
                    continue

                t = min(1.0, elapsed / duration)
                eased_t = easing_fn(t)
                angle = start + (end - start) * eased_t
                servo.set_angle(angle)

            if not await self._abortable_sleep_async(STEP_INTERVAL):
                return False

        # Ensure all servos reach their final target
        for servo, start, end, duration in movements:
            servo.set_angle(end)

        return True

    def execute_command(
        self,
        command: str,
        easing: str | Callable[[float], float] = "ease_in_out_cubic",
    ) -> bool:
        """Execute a movement-tool format command string.

        Format: [SPEED_]PIN:ANGLE[/PIN:ANGLE...]

        Args:
            command: Command string (e.g., "F_20:45/21:-30")
            easing: Easing function name or callable

        Returns:
            True if completed successfully, False if aborted
        """
        parsed = parse_command(command)
        return self._execute_parsed(parsed, easing)

    async def execute_command_async(
        self,
        command: str,
        easing: str | Callable[[float], float] = "ease_in_out_cubic",
    ) -> bool:
        """Async version of execute_command.

        Args:
            command: Command string
            easing: Easing function name or callable

        Returns:
            True if completed successfully, False if aborted
        """
        parsed = parse_command(command)
        return await self._execute_parsed_async(parsed, easing)

    def _execute_parsed(
        self,
        parsed: ParsedCommand,
        easing: str | Callable[[float], float],
    ) -> bool:
        """Execute a parsed command with per-target speed support."""
        targets, speed_modes = self._resolve_targets(parsed.targets, parsed.speed_mode)
        return self.move_all_sync(targets, speed_modes, easing)

    async def _execute_parsed_async(
        self,
        parsed: ParsedCommand,
        easing: str | Callable[[float], float],
    ) -> bool:
        """Async execution of parsed command."""
        targets, speed_modes = self._resolve_targets(parsed.targets, parsed.speed_mode)
        return await self.move_all_async(targets, speed_modes, easing)

    def _resolve_targets(
        self, targets: list[ServoTarget], global_speed: str = "M"
    ) -> tuple[list[float | None], list[str]]:
        """Convert ServoTargets to angle list and speed list indexed by pin order.

        Returns:
            Tuple of (angles, speed_modes) where each list is indexed by pin order
        """
        result: list[float | None] = [None] * len(self._pins)
        speeds: list[str] = [global_speed] * len(self._pins)

        for target in targets:
            if target.pin not in self._servos:
                logger.warning(f"Unknown pin in command: {target.pin}")
                continue

            pin_index = self._pins.index(target.pin)
            servo = self._servos[target.pin]

            if target.angle is not None:
                result[pin_index] = target.angle
            elif target.special:
                # Resolve special position using servo calibration
                cal_dict = {
                    "angle_center": servo.calibration.angle_center,
                    "angle_min": servo.calibration.angle_min,
                    "angle_max": servo.calibration.angle_max,
                }
                result[pin_index] = resolve_special_angle(target.special, cal_dict)

            # Use per-target speed if specified, otherwise keep global
            if target.speed:
                speeds[pin_index] = target.speed

        return result, speeds

    # --- Actuator Interface (ninja_utils) ---

    def initialize(self):
        """Initialize all servos (Actuator interface)."""
        logger.info(f"ServoGroup initialized with pins: {self._pins}")

    def execute(self, command: str) -> dict:
        """Execute a command (Actuator interface).

        Args:
            command: Movement-tool format string

        Returns:
            Dict with 'success' bool and 'message' string
        """
        try:
            success = self.execute_command(command)
            return {
                "success": success,
                "message": "Completed" if success else "Aborted",
            }
        except ValueError as e:
            return {"success": False, "message": str(e)}

    def off(self):
        """Turn off all servos (Actuator interface)."""
        for servo in self._servos.values():
            servo.off()
        logger.info("All servos turned off")

    def refresh_all(self):
        """Re-send PWM to all servos with known positions.

        Use this to restore all servo positions after potential signal loss.
        Prevents servo limpness by ensuring PWM signals are active.
        """
        count = 0
        for servo in self._servos.values():
            if servo.refresh():
                count += 1
        if count > 0:
            logger.info(f"Refreshed PWM on {count} servos")

    def ensure_all_active(self):
        """Check and restore PWM on all servos if needed.

        Returns:
            Number of servos that were restored
        """
        restored = 0
        for servo in self._servos.values():
            current_pulse = servo.get_pulse()
            if current_pulse == 0 and servo.last_angle is not None:
                servo.refresh()
                restored += 1
        if restored > 0:
            logger.info(f"Restored PWM on {restored} limp servos")

    def center_all(self):
        """Move all servos to their calibrated center position."""
        for servo in self._servos.values():
            servo.move_to_center()

    # --- Legacy API (backward compatibility with ninja_core) ---

    def move_all_angles_sync(
        self,
        target_angles: list[float | None],
        move_sec: float = 0.5,
        step_n: int = 40,
    ) -> bool:
        """Legacy wrapper for ninja_core compatibility.

        Maps duration-based call to velocity-based movement.

        Args:
            target_angles: List of target angles (same order as pins). None = skip.
            move_sec: Movement duration (used to determine speed mode)
            step_n: Ignored (kept for signature compatibility)

        Returns:
            True if completed successfully, False if aborted
        """
        # Map duration to speed mode
        if move_sec <= 0.2:
            speed_mode = "F"
        elif move_sec <= 0.5:
            speed_mode = "M"
        else:
            speed_mode = "S"

        return self.move_all_sync(target_angles, speed_mode=speed_mode)

    def move_all_angles(self, target_angles: list[float | None]):
        """Legacy compatibility: instant movement (no interpolation).

        Used by ninja_core's movement_controller for non-sync moves.

        Args:
            target_angles: List of target angles (same order as pins). None = skip.
        """
        for i, pin in enumerate(self._pins):
            if i < len(target_angles) and target_angles[i] is not None:
                self._servos[pin].set_angle(target_angles[i])

    def get_all_angles(self) -> list[float]:
        """Legacy compatibility: get all angles as ordered list.

        Used by ninja_core's movement_controller for reading current state.

        Returns:
            List of angles in pin order.
        """
        return [self._servos[pin].last_angle or 0.0 for pin in self._pins]

    @property
    def servo(self) -> list:
        """Legacy compatibility: list access (ordered by pin).

        Used by ninja_core's api_wrappers for list-style access.

        Returns:
            List of Servo objects in pin order.
        """
        return [self._servos[pin] for pin in self._pins]
