Nilcreator/NinjaRobotV5/ninja_core/src/ninja_core/facial_expressions.py

from __future__ import annotations

import logging
import math
import threading
import time
from typing import TYPE_CHECKING, Callable, Dict, Optional

from PIL import Image, ImageDraw, ImageFont

log = logging.getLogger(__name__)

if TYPE_CHECKING:
    from ninja_core.hal import HardwareAbstractionLayer


class AnimatedFaces:
    """
    Generates and displays programmatically drawn, animated facial expressions.
    This class is thread-safe and integrates with the HAL.
    """

    def __init__(self, hal: Optional[HardwareAbstractionLayer]):
        if hal and getattr(hal, "display", None):
            self.lcd = hal.display
            self.width, self.height = self.lcd.width, self.lcd.height
        else:
            # Dummy values for introspection
            self.lcd = None
            self.width, self.height = 240, 240

        self.bg_color = "black"
        self.face_color = "white"
        self.blush_color = "#FF69B4"
        self.tear_color = "#00BFFF"

        self._animation_thread = None
        self._stop_event = threading.Event()

        # Style guide
        self.center_x = self.width // 2
        self.center_y = self.height // 2
        self.eye_y = self.center_y - 35
        self.mouth_y = self.center_y + 50
        self.eye_offset = 60
        self.eye_radius = 45
        self.pupil_radius = 20
        self.line_width = 12

        try:
            self.font = ImageFont.truetype("Pillow/Tests/fonts/FreeMono.ttf", 50)
        except IOError:
            self.font = ImageFont.load_default()

        # Map expression names to their animation logic
        self.animations: Dict[str, Callable] = {
            "idle": self._logic_idle,
            "happy": self._logic_happy,
            "laughing": self._logic_laughing,
            "sad": self._logic_sad,
            "cry": self._logic_cry,
            "angry": self._logic_angry,
            "surprising": self._logic_surprising,
            "sleepy": self._logic_sleepy,
            "speaking": self._logic_speaking,
            "shy": self._logic_shy,
            "embarrassing": self._logic_shy,  # Alias
            "scary": self._logic_scary,
            "exciting": self._logic_exciting,
            "confusing": self._logic_confusing,
        }

    def play(self, expression: str, duration_s: float = 3.0):
        """
        Plays a facial expression animation for a given duration.
        If the expression is unknown, it does nothing.
        An infinite duration can be set with float('inf').
        """
        logic_func = self.animations.get(expression)
        if logic_func:
            print(f"Playing: {expression}")
            self._start_animation(duration_s, logic_func)
        else:
            print(f"Warning: Unknown expression '{expression}'")

    def stop(self):
        """Stops the current animation thread and waits for it to exit."""
        if self._animation_thread and self._animation_thread.is_alive():
            self._stop_event.set()
            self._animation_thread.join(timeout=1.0)
            if self._animation_thread.is_alive():
                print("⚠️ Animation thread did not stop in time.")

    def _get_blank_image(self):
        return Image.new("RGB", (self.width, self.height), self.bg_color)

    def _animation_loop(self, duration_s, frame_logic):
        """The actual loop that runs in a thread to draw frames."""
        start_time = time.time()
        while not self._stop_event.is_set() and (time.time() - start_time < duration_s):
            if self.lcd is None:
                # If no display, just sleep to simulate timing or break
                time.sleep(1 / 60)
                continue

            image = self._get_blank_image()
            draw = ImageDraw.Draw(image)
            frame_logic(draw, time.time() - start_time)
            try:
                # Check for display validity
                if self.lcd:
                    self.lcd.display(image)
            except Exception as e:
                # Log the error so display failures are visible in console
                log.error("Display rendering failed: %s", e, exc_info=True)
                break
            time.sleep(1 / 60)  # ~60 FPS

    def _start_animation(self, duration_s, frame_logic):
        """Stops any running animation and starts a new one."""
        self.stop()  # Safely stop the previous thread

        self._stop_event.clear()
        self._animation_thread = threading.Thread(
            target=self._animation_loop, args=(duration_s, frame_logic)
        )
        self._animation_thread.start()

    # --- Base Drawing Helpers ---
    def _draw_base_eyes(self, draw, left_pupil_shift=(0, 0), right_pupil_shift=(0, 0)):
        lx, ly = self.center_x - self.eye_offset, self.eye_y
        draw.ellipse(
            [
                lx - self.eye_radius,
                ly - self.eye_radius,
                lx + self.eye_radius,
                ly + self.eye_radius,
            ],
            fill=self.face_color,
        )
        lpx, lpy = lx + left_pupil_shift[0], ly + left_pupil_shift[1]
        draw.ellipse(
            [
                lpx - self.pupil_radius,
                lpy - self.pupil_radius,
                lpx + self.pupil_radius,
                lpy + self.pupil_radius,
            ],
            fill=self.bg_color,
        )

        rx, ry = self.center_x + self.eye_offset, self.eye_y
        draw.ellipse(
            [
                rx - self.eye_radius,
                ry - self.eye_radius,
                rx + self.eye_radius,
                ry + self.eye_radius,
            ],
            fill=self.face_color,
        )
        rpx, rpy = rx + right_pupil_shift[0], ry + right_pupil_shift[1]
        draw.ellipse(
            [
                rpx - self.pupil_radius,
                rpy - self.pupil_radius,
                rpx + self.pupil_radius,
                rpy + self.pupil_radius,
            ],
            fill=self.bg_color,
        )

    def _draw_happy_base(self, draw):
        self._draw_base_eyes(draw)
        eyebrow_y = self.eye_y - self.eye_radius - (self.line_width / 2) - 5
        draw.arc(
            [
                self.center_x - self.eye_offset - 40,
                eyebrow_y - 40,
                self.center_x - self.eye_offset + 40,
                eyebrow_y,
            ],
            0,
            180,
            fill=self.face_color,
            width=self.line_width,
        )
        draw.arc(
            [
                self.center_x + self.eye_offset - 40,
                eyebrow_y - 40,
                self.center_x + self.eye_offset + 40,
                eyebrow_y,
            ],
            0,
            180,
            fill=self.face_color,
            width=self.line_width,
        )
        draw.arc(
            [
                self.center_x - 70,
                self.mouth_y - 50,
                self.center_x + 70,
                self.mouth_y + 50,
            ],
            0,
            180,
            fill=self.face_color,
        )

    def _draw_sad_base(self, draw):
        pupil_shift = (0, 15)
        self._draw_base_eyes(draw, pupil_shift, pupil_shift)
        draw.line(
            [
                self.center_x - self.eye_offset - 30,
                self.eye_y - 50,
                self.center_x - self.eye_offset + 10,
                self.eye_y - 70,
            ],
            fill=self.face_color,
            width=self.line_width,
        )
        draw.line(
            [
                self.center_x + self.eye_offset + 30,
                self.eye_y - 50,
                self.center_x + self.eye_offset - 10,
                self.eye_y - 70,
            ],
            fill=self.face_color,
            width=self.line_width,
        )
        draw.arc(
            [
                self.center_x - 60,
                self.mouth_y + 20,
                self.center_x + 60,
                self.mouth_y + 80,
            ],
            180,
            360,
            fill=self.face_color,
        )

    # --- Animation Logic Methods ---
    def _logic_idle(self, draw, t):
        blink_cycle = (t * 2) % 3
        if blink_cycle < 0.15:
            draw.line(
                [
                    self.center_x - self.eye_offset - 30,
                    self.eye_y,
                    self.center_x - self.eye_offset + 30,
                    self.eye_y,
                ],
                fill=self.face_color,
                width=self.line_width,
            )
            draw.line(
                [
                    self.center_x + self.eye_offset - 30,
                    self.eye_y,
                    self.center_x + self.eye_offset + 30,
                    self.eye_y,
                ],
                fill=self.face_color,
                width=self.line_width,
            )
        else:
            self._draw_base_eyes(draw)
        draw.arc(
            [
                self.center_x - 50,
                self.mouth_y - 10,
                self.center_x + 50,
                self.mouth_y + 10,
            ],
            0,
            180,
            fill=self.face_color,
        )

    def _logic_happy(self, draw, t):
        self._draw_happy_base(draw)

    def _logic_laughing(self, draw, t):
        self._draw_happy_base(draw)
        mouth_height = abs(math.sin(t * 15)) * 60
        draw.rectangle(
            [
                self.center_x - 70,
                self.mouth_y,
                self.center_x + 70,
                self.mouth_y + mouth_height,
            ],
            fill=self.bg_color,
        )

    def _logic_sad(self, draw, t):
        self._draw_sad_base(draw)

    def _logic_cry(self, draw, t):
        self._draw_sad_base(draw)
        tear_y_base = self.eye_y + self.eye_radius
        tear_length = self.height - tear_y_base
        for i in range(3):
            tear_y = tear_y_base + (t * 200 + i * 40) % tear_length
            draw.line(
                [
                    self.center_x - self.eye_offset,
                    tear_y,
                    self.center_x - self.eye_offset,
                    tear_y + 30,
                ],
                fill=self.tear_color,
                width=self.line_width,
            )

    def _logic_angry(self, draw, t):
        shake = math.sin(t * 20) * 3
        self._draw_base_eyes(draw)
        draw.line(
            [
                self.center_x - self.eye_offset - 40,
                self.eye_y - 30 + shake,
                self.center_x - self.eye_offset + 40,
                self.eye_y - 70 + shake,
            ],
            fill=self.face_color,
            width=self.line_width,
        )
        draw.line(
            [
                self.center_x + self.eye_offset + 40,
                self.eye_y - 30 + shake,
                self.center_x + self.eye_offset - 40,
                self.eye_y - 70 + shake,
            ],
            fill=self.face_color,
            width=self.line_width,
        )
        draw.arc(
            [
                self.center_x - 70,
                self.mouth_y - 20,
                self.center_x + 70,
                self.mouth_y + 80,
            ],
            180,
            360,
            fill=self.face_color,
        )

    def _logic_surprising(self, draw, t):
        open_factor = min(1, t * 4)
        pupil_radius_factor = 1 - (open_factor * 0.5)
        current_pupil_radius = self.pupil_radius * pupil_radius_factor
        lx, ly = self.center_x - self.eye_offset, self.eye_y
        draw.ellipse(
            [
                lx - self.eye_radius,
                ly - self.eye_radius,
                lx + self.eye_radius,
                ly + self.eye_radius,
            ],
            fill=self.face_color,
        )
        draw.ellipse(
            [
                lx - current_pupil_radius,
                ly - current_pupil_radius,
                lx + current_pupil_radius,
                ly + current_pupil_radius,
            ],
            fill=self.bg_color,
        )
        rx, ry = self.center_x + self.eye_offset, self.eye_y
        draw.ellipse(
            [
                rx - self.eye_radius,
                ry - self.eye_radius,
                rx + self.eye_radius,
                ry + self.eye_radius,
            ],
            fill=self.face_color,
        )
        draw.ellipse(
            [
                rx - current_pupil_radius,
                ry - current_pupil_radius,
                rx + current_pupil_radius,
                ry + current_pupil_radius,
            ],
            fill=self.bg_color,
        )
        mouth_radius = min(50, t * 120)
        draw.ellipse(
            [
                self.center_x - mouth_radius,
                self.mouth_y - mouth_radius,
                self.center_x + mouth_radius,
                self.mouth_y + mouth_radius,
            ],
            fill=self.face_color,
        )

    def _logic_sleepy(self, draw, t):
        open_factor = (math.cos(t * 1.5) + 1) / 2 * 0.9 + 0.05
        ly, ry = self.eye_y, self.eye_y
        draw.arc(
            [
                self.center_x - self.eye_offset - self.eye_radius,
                ly - self.eye_radius,
                self.center_x - self.eye_offset + self.eye_radius,
                ly + self.eye_radius,
            ],
            180,
            360,
            fill=self.face_color,
        )
        draw.arc(
            [
                self.center_x + self.eye_offset - self.eye_radius,
                ry - self.eye_radius,
                self.center_x + self.eye_offset + self.eye_radius,
                ry + self.eye_radius,
            ],
            180,
            360,
            fill=self.face_color,
        )
        draw.arc(
            [
                self.center_x - self.eye_offset - self.eye_radius,
                ly - self.eye_radius,
                self.center_x - self.eye_offset + self.eye_radius,
                ly + self.eye_radius,
            ],
            0,
            180,
            fill=self.face_color,
            width=self.line_width,
        )
        draw.arc(
            [
                self.center_x + self.eye_offset - self.eye_radius,
                ry - self.eye_radius,
                self.center_x + self.eye_offset + self.eye_radius,
                ry + self.eye_radius,
            ],
            0,
            180,
            fill=self.face_color,
            width=self.line_width,
        )
        draw.rectangle(
            [
                0,
                self.eye_y - self.eye_radius,
                self.width,
                self.eye_y
                - self.eye_radius
                + (self.eye_radius * 2) * (1 - open_factor),
            ],
            fill=self.bg_color,
        )
        draw.arc(
            [
                self.center_x - 20,
                self.mouth_y - 10,
                self.center_x + 20,
                self.mouth_y + 10,
            ],
            0,
            360,
            fill=self.face_color,
        )

    def _logic_speaking(self, draw, t):
        self._draw_base_eyes(draw)
        mouth_height = (math.sin(t * 15) + 1) / 2 * 40 + 10
        draw.ellipse(
            [
                self.center_x - 50,
                self.mouth_y,
                self.center_x + 50,
                self.mouth_y + mouth_height,
            ],
            fill=self.face_color,
        )

    def _logic_shy(self, draw, t):
        pupil_shift = (-20, 15)
        self._draw_base_eyes(draw, pupil_shift, pupil_shift)
        blush_y = self.eye_y + self.eye_radius / 2
        blush_radius = 25
        draw.ellipse(
            [
                self.center_x - self.eye_offset - 15,
                blush_y,
                self.center_x - self.eye_offset + 35,
                blush_y + blush_radius,
            ],
            fill=self.blush_color,
        )
        draw.ellipse(
            [
                self.center_x + self.eye_offset - 35,
                blush_y,
                self.center_x + self.eye_offset + 15,
                blush_y + blush_radius,
            ],
            fill=self.blush_color,
        )
        points = [
            self.center_x - 40,
            self.mouth_y + 10,
            self.center_x - 20,
            self.mouth_y,
            self.center_x,
            self.mouth_y + 10,
            self.center_x + 20,
            self.mouth_y,
            self.center_x + 40,
            self.mouth_y + 10,
        ]
        draw.line(
            points, fill=self.face_color, width=self.line_width - 2, joint="curve"
        )

    def _logic_scary(self, draw, t):
        current_pupil_radius = 10
        shake = math.sin(t * 50) * 4
        lx, ly = self.center_x - self.eye_offset, self.eye_y
        draw.ellipse(
            [
                lx - self.eye_radius,
                ly - self.eye_radius,
                lx + self.eye_radius,
                ly + self.eye_radius,
            ],
            fill=self.face_color,
        )
        lpx, lpy = lx, ly + shake
        draw.ellipse(
            [
                lpx - current_pupil_radius,
                lpy - current_pupil_radius,
                lpx + current_pupil_radius,
                lpy + current_pupil_radius,
            ],
            fill=self.bg_color,
        )
        rx, ry = self.center_x + self.eye_offset, self.eye_y
        draw.ellipse(
            [
                rx - self.eye_radius,
                ry - self.eye_radius,
                rx + self.eye_radius,
                ry + self.eye_radius,
            ],
            fill=self.face_color,
        )
        rpx, rpy = rx, ry + shake
        draw.ellipse(
            [
                rpx - current_pupil_radius,
                rpy - current_pupil_radius,
                rpx + current_pupil_radius,
                rpy + current_pupil_radius,
            ],
            fill=self.bg_color,
        )
        draw.arc(
            [
                self.center_x - 70,
                self.mouth_y - 20,
                self.center_x + 70,
                self.mouth_y + 80,
            ],
            180,
            360,
            fill=self.face_color,
        )

    def _logic_exciting(self, draw, t):
        star_points = 10
        for eye_center_x in [
            self.center_x - self.eye_offset,
            self.center_x + self.eye_offset,
        ]:
            angle = math.pi * 2 / star_points
            points = []
            for i in range(star_points):
                r = self.eye_radius if i % 2 == 0 else self.eye_radius / 2
                points.append(
                    (
                        eye_center_x + r * math.cos(angle * i + t * 10),
                        self.eye_y + r * math.sin(angle * i + t * 10),
                    )
                )
            draw.polygon(points, fill=self.face_color)
        draw.arc(
            [
                self.center_x - 70,
                self.mouth_y - 50,
                self.center_x + 70,
                self.mouth_y + 50,
            ],
            0,
            180,
            fill=self.face_color,
        )

    def _logic_confusing(self, draw, t):
        self._draw_base_eyes(draw, (-15, 0), (15, 0))
        draw.arc(
            [
                self.center_x - self.eye_offset - 40,
                self.eye_y - 90,
                self.center_x - self.eye_offset + 40,
                self.eye_y - 10,
            ],
            0,
            180,
            fill=self.face_color,
            width=self.line_width,
        )
        points = [
            self.center_x - 50,
            self.mouth_y + 10,
            self.center_x - 25,
            self.mouth_y - 10,
            self.center_x,
            self.mouth_y + 10,
            self.center_x + 25,
            self.mouth_y - 10,
            self.center_x + 50,
            self.mouth_y + 10,
        ]
        draw.line(
            points, fill=self.face_color, width=self.line_width - 2, joint="curve"
        )
        if t > 0.5:
            draw.text(
                (self.center_x + self.eye_offset + 10, self.eye_y - 100),
                "?",
                font=self.font,
                fill=self.face_color,
            )
