Nilcreator/NinjaRobotV5/tests/test_api_wrappers.py

import logging

import pytest

from ninja_core.api_wrappers import (
    BuzzerWrapper,
    DisplayWrapper,
    DistanceWrapper,
    RobotWrapper,
    ServoArrayWrapper,
    ServoWrapper,
)


def test_distance_wrapper_returns_sensor_distance():
    class FakeSensor:
        def get_data(self):
            return {"distance_mm": 123, "is_valid": True}

    assert DistanceWrapper(FakeSensor()).read() == 123


def test_distance_wrapper_returns_fallback_for_invalid_sensor_data(caplog):
    class FakeSensor:
        def get_data(self):
            return {"distance_mm": -1, "is_valid": False}

    with caplog.at_level(logging.WARNING):
        assert DistanceWrapper(FakeSensor()).read() == 9999

    assert "Distance read unavailable or invalid" in caplog.text


def test_servo_wrapper_clamps_out_of_range_angles_and_logs(caplog):
    servo = ServoWrapper(None, 0)

    with caplog.at_level(logging.WARNING):
        servo.angle = 120

    assert servo.angle == 90
    assert "out-of-range servo angle 120" in caplog.text


def test_servo_wrapper_move_clamps_negative_angles_and_logs(caplog):
    servo = ServoWrapper(None, 1)

    with caplog.at_level(logging.WARNING):
        servo.move(-120, duration=0.5)

    assert servo.angle == -90
    assert "out-of-range servo angle -120" in caplog.text


def test_servo_array_move_pin_uses_gpio_pin_and_speed_mode(caplog):
    class FakeServoGroup:
        pins = [20, 21, 22]

        def __init__(self):
            self.calls = []

        def move_all_sync(self, targets, speed_mode="M", easing=None, force=False):
            self.calls.append(
                {
                    "targets": targets,
                    "speed_mode": speed_mode,
                    "easing": easing,
                    "force": force,
                }
            )
            return True

    group = FakeServoGroup()
    servos = ServoArrayWrapper(group, count=len(group.pins))

    with caplog.at_level(logging.WARNING):
        assert servos.move_pin(21, 120, speed_mode="F") is True

    assert group.calls == [
        {
            "targets": [None, 90, None],
            "speed_mode": ["F", "F", "F"],
            "easing": "ease_in_out_cubic",
            "force": True,
        }
    ]
    assert "out-of-range servo angle 120" in caplog.text


def test_servo_array_move_pins_supports_per_servo_speeds():
    class FakeServoGroup:
        pins = [20, 21, 22]

        def __init__(self):
            self.calls = []

        def move_all_sync(self, targets, speed_mode="M", easing=None, force=False):
            self.calls.append((targets, speed_mode, easing, force))
            return True

    group = FakeServoGroup()
    servos = ServoArrayWrapper(group, count=len(group.pins))

    assert servos.move_pins(
        {20: 45, 22: -30},
        speed_mode="S",
        per_servo_speeds={22: "F"},
    ) is True

    assert group.calls == [
        ([45, None, -30], ["S", "S", "F"], "ease_in_out_cubic", True)
    ]


def test_servo_array_move_pins_rejects_unknown_gpio_pin():
    class FakeServoGroup:
        pins = [20, 21]

    servos = ServoArrayWrapper(FakeServoGroup(), count=2)

    with pytest.raises(ValueError, match="Servo GPIO pin"):
        servos.move_pins({27: 45})

    with pytest.raises(ValueError, match="Servo GPIO speed override"):
        servos.move_pins({20: 45}, per_servo_speeds={27: "F"})


def test_servo_array_move_pins_defaults_invalid_speed_mode(caplog):
    class FakeServoGroup:
        pins = [20]

        def __init__(self):
            self.calls = []

        def move_all_sync(self, targets, speed_mode="M", easing=None, force=False):
            self.calls.append((targets, speed_mode))
            return True

    group = FakeServoGroup()
    servos = ServoArrayWrapper(group, count=1)

    with caplog.at_level(logging.WARNING):
        servos.move_pin(20, 30, speed_mode="turbo")

    assert group.calls == [([30], ["M"])]
    assert "invalid servo speed mode turbo" in caplog.text


def test_buzzer_wrapper_play_song_uses_named_song_api():
    class FakeBuzzer:
        def __init__(self):
            self.off_called = False
            self.initialize_called = False
            self.played_song = None

        def play_named_song(self, name):
            self.played_song = name

        def off(self):
            self.off_called = True

        def initialize(self):
            self.initialize_called = True

    class FakeHal:
        def __init__(self):
            self.buzzer = FakeBuzzer()

    wrapper = BuzzerWrapper(FakeHal())
    wrapper.play_song("jingle_bells")

    assert wrapper._hal.buzzer.off_called is True
    assert wrapper._hal.buzzer.initialize_called is True
    assert wrapper._hal.buzzer.played_song == "jingle_bells"


def test_robot_wrapper_request_stop_preserves_display_for_idle_restore(monkeypatch):
    class FakeFaces:
        def __init__(self, hal):
            self.hal = hal
            self.stop_called = False

        def stop(self):
            self.stop_called = True

    class FakeComponent:
        def __init__(self):
            self.off_called = False

        def off(self):
            self.off_called = True

    class FakeHal:
        def __init__(self):
            self.buzzer = FakeComponent()
            self.display = FakeComponent()
            self.servos = FakeComponent()
            self.distance_sensor = None

    monkeypatch.setattr("ninja_core.api_wrappers.AnimatedFaces", FakeFaces)
    robot = RobotWrapper(FakeHal())

    robot.request_stop()

    assert robot._faces.stop_called is True
    assert robot._hal.buzzer.off_called is True
    assert robot._hal.display.off_called is False
    assert robot._hal.servos.off_called is True


def test_robot_wrapper_request_stop_stops_active_text_ticker(monkeypatch):
    class FakeFaces:
        def __init__(self, hal):
            self.hal = hal

        def stop(self):
            return None

    class FakeComponent:
        def __init__(self):
            self.off_called = False

        def off(self):
            self.off_called = True

    class FakeHal:
        def __init__(self):
            self.buzzer = FakeComponent()
            self.display = FakeComponent()
            self.servos = FakeComponent()
            self.distance_sensor = None

    class FakeTicker:
        def __init__(self):
            self.stop_called = False

        def stop(self):
            self.stop_called = True

    monkeypatch.setattr("ninja_core.api_wrappers.AnimatedFaces", FakeFaces)
    robot = RobotWrapper(FakeHal())
    ticker = FakeTicker()
    robot.display._active_ticker = ticker

    robot.request_stop()

    assert ticker.stop_called is True
    assert robot._hal.display.off_called is False


def test_robot_wrapper_uses_shared_faces_for_expressions():
    class SharedFaces:
        def __init__(self):
            self.play_calls = []

        def play(self, name, duration_s):
            self.play_calls.append((name, duration_s))

    class FakeHal:
        buzzer = None
        display = None
        distance_sensor = None
        servos = None

    faces = SharedFaces()
    robot = RobotWrapper(FakeHal(), cooperative_sleep=lambda duration: None, faces=faces)

    robot.expression("angry", duration=2.0)

    assert robot._faces is faces
    assert faces.play_calls == [("angry", 2.0)]


def test_display_clear_marks_blockly_display_hold():
    class FakeDisplay:
        def __init__(self):
            self.commands = []

        def execute(self, command):
            self.commands.append(command)

    class FakeHal:
        def __init__(self):
            self.display = FakeDisplay()

    class FakeRuntimePipeline:
        def __init__(self):
            self.hold_called = False

        def mark_display_hold(self):
            self.hold_called = True

    hal = FakeHal()
    pipeline = FakeRuntimePipeline()

    DisplayWrapper(hal, runtime_pipeline=pipeline).clear()

    assert hal.display.commands == [{"clear": True}]
    assert pipeline.hold_called is True


def test_display_text_static_renders_image_and_waits():
    class FakeDisplay:
        width = 240
        height = 320

        def __init__(self):
            self.commands = []

        def execute(self, command):
            self.commands.append(command)

    class FakeHal:
        def __init__(self):
            self.display = FakeDisplay()

    sleep_calls = []
    hal = FakeHal()

    DisplayWrapper(hal, cooperative_sleep=sleep_calls.append).text("Hello NinjaRobot", duration=1.5)

    assert sleep_calls == [1.5]
    assert len(hal.display.commands) == 1
    assert "image" in hal.display.commands[0]


def test_display_text_scroll_starts_and_stops_ticker(monkeypatch):
    events = []

    class FakeDisplay:
        width = 240
        height = 320

        def execute(self, command):
            raise AssertionError(f"scrolling text should not call execute: {command}")

    class FakeHal:
        def __init__(self):
            self.display = FakeDisplay()

    class FakeTicker:
        def __init__(self, lcd, text, font_size, color, bg_color, speed, language):
            events.append(
                {
                    "lcd": lcd,
                    "text": text,
                    "font_size": font_size,
                    "color": color,
                    "bg_color": bg_color,
                    "speed": speed,
                    "language": language,
                }
            )

        def start(self):
            events.append("start")

        def stop(self):
            events.append("stop")

    monkeypatch.setattr("ninja_core.api_wrappers.TextTicker", FakeTicker)
    sleep_calls = []
    hal = FakeHal()

    DisplayWrapper(hal, cooperative_sleep=sleep_calls.append).text(
        "Scroll me",
        scroll=True,
        duration=2.0,
        speed=3.5,
    )

    assert sleep_calls == [2.0]
    assert events[0]["text"] == "Scroll me"
    assert events[0]["speed"] == 3.5
    assert events[1:] == ["start", "stop"]
