Nilcreator/NinjaRobotV5/(commit log)

2026-01-03 fix the BLE protocol issues01
    [dispatcher.py, web_server.py]
2026-01-03 fix the BLE protocol issues02
    [dispatcher.py, safe_executor.py, test_safe_executor.py, web_server.py]
2026-01-03 fix the BLE protocol issues03
    [safe_executor.py, test_safe_executor.py]
2026-01-03 fix the BLE protocol issues04
    [safe_executor.py, test_safe_executor.py]
2026-01-03 fix the BLE protocol issues05
    [dispatcher.py]
2026-01-03 fix the BLE protocol issues06
    [web_server.py]
2026-01-04 fix Phase 5 error01
    [web_server.py]
2026-01-04 fix Phase 5 error02
    [web_server.py]
2026-01-04 fix Phase 5 error03
    [ninja_agent.py]
2026-01-04 fix Phase5 implementation error0ˊ
2026-01-04 fix Phase5 implementation error07
    [web_server.py]
2026-01-04 fix Phase5 implementation error08
    [web_server.py]
2026-01-04 fix Phase5 implementation error09
    [web_server.py]
2026-01-04 fix Phase5 implementation error10
    [web_server.py]
2026-01-04 fix Phase5 implementation error11
    [web_server.py]
2026-01-04 fix Phase5 implementation error12
    [web_server.py]
2026-01-07 fix ninja server shut down error
    [facial_expressions.py, perception.py, web_server.py]
2026-01-07 fix ninja server shut down error02
    [web_server.py]
2026-01-07 fix ninja server shut down error03
    [web_server.py]
2026-02-06 starting rebuilding drivers
2026-02-07 refine pi0servo servo-tool
2026-02-07 Add speed setting to separate servo
2026-02-08 calibration error 01
2026-02-08 fix pi0servo integration error 01
    [config.py]
2026-02-08 fix pi0servo integration error 02
    [config.py, movement_cli.py]
2026-02-08 fix pi0servo integration error 03
    [movement_cli.py, movement_controller.py]
2026-02-08 fix pi0servo integration error 05
    [movement_cli.py]
2026-02-08 fix pi0servo integration error 06
    [movement_cli.py]
2026-02-09 update the servo ease setting
2026-02-09 optimize servo smoothness
2026-02-09 auto center feature for servo-tool and movement-tool
2026-02-15 fix sensor-tool o1
2026-02-25 fix gpio not found error
    [__main__.py, demo_cmd.py, display_tool.py, image_cmd.py, info_cmd.py, text_cmd.py]
2026-02-25 fix gpio not found error03
    [config.py, config_manager.py, driver.py, hal.py, test_driver.py]
2026-02-25 fix gpio not found error04
    [driver.py, facial_expressions.py, hal.py, test_driver.py, web_server.py]
2026-02-25 fix gpio not found error05
    [config.py, hal.py]
2026-02-26 fix the pi0buzzer error01
    [__main__.py, config_manager.py, driver.py, music.py]
2026-03-04 add model switching markdown file
2026-04-21 fix bluetooth connection 02
    [test_ble_service.py, web_server.py]
2026-04-21 fix bluetooth connection 03
    [test_ble_service.py]
2026-04-21 fix bluetooth connection 04
    [test_ble_service.py]
2026-04-21 fix blockly interpreter 01
    [contracts.py, dispatcher.py, safe_executor.py, test_contracts.py, test_dispatcher.py, test_safe_executor.py]
2026-04-21 fix blockly interpreter 02
    [__main__.py, perception.py, sensor.py, sensor_tool.py, test_api_wrappers.py, test_perception.py, test_sensor.py]
2026-04-23 refine servo blockly execution01
2026-04-23 fix BLE rename error01
    [__main__.py]
2026-04-27 add 3D models
    [NinjaV5_Bottom.stl, NinjaV5_LED.stl, NinjaV5_Middle.stl, NinjaV5_Top.stl, SastukeV5_Arm_Left.stl, SastukeV5_Feet_Right.stl, SastukeV5_Legs.stl, SastukeV5_SeovoHolder_Left.stl]
2026-09-01 add model selection function
    [servo.json]
2026-09-01 update git ignore files
    [servo.json]
